intmushfiq/6-DOF-Robotic-Arm/Circuit Diagram.jpg

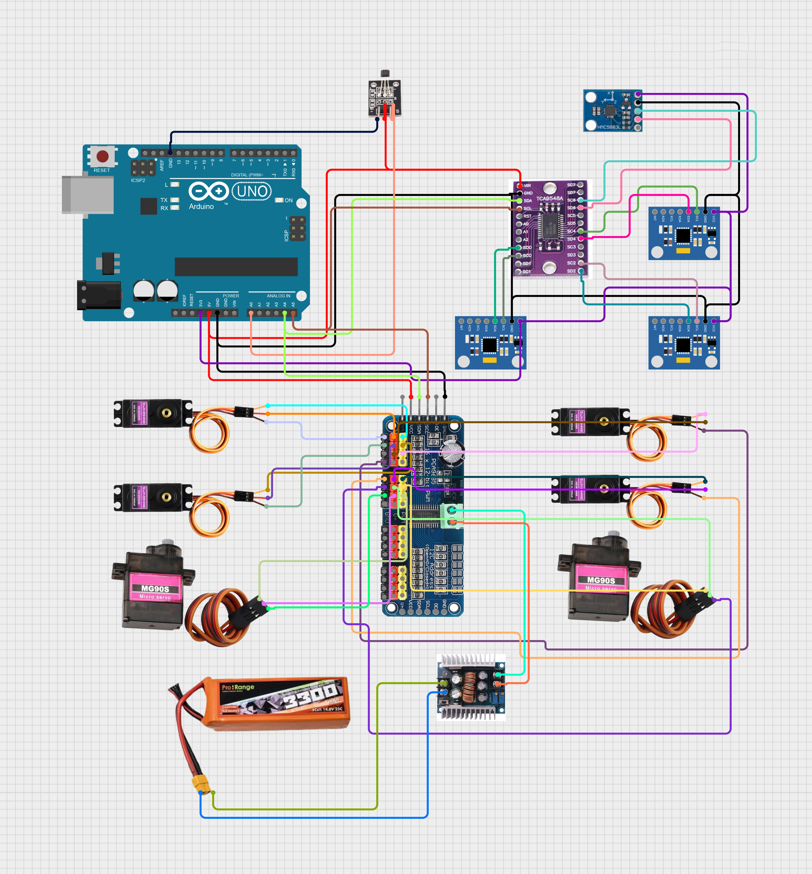
Circuit Diagram.jpg
